jramsay42/Digital-Multimeter-v0.01/Multimeter.pdf

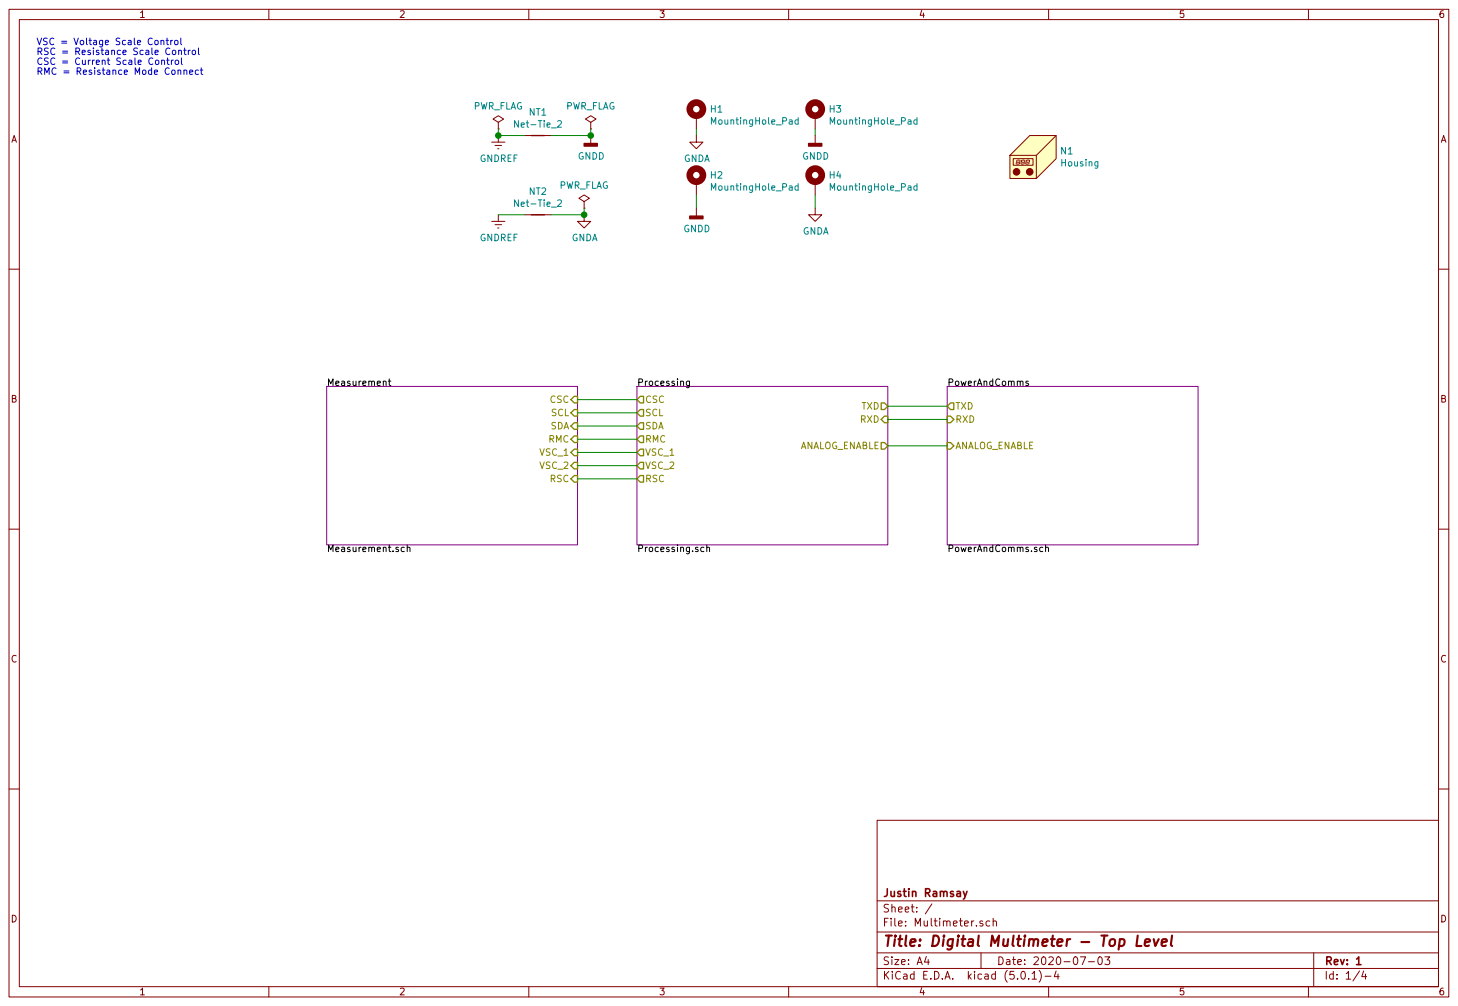
[picture p1: page 1]

PowerAndComms PowerAndComms.sch TXD

Id: 1/4 Title: Digital Multimeter - Top Level File: Multimeter.sch Sheet: / Justin Ramsay

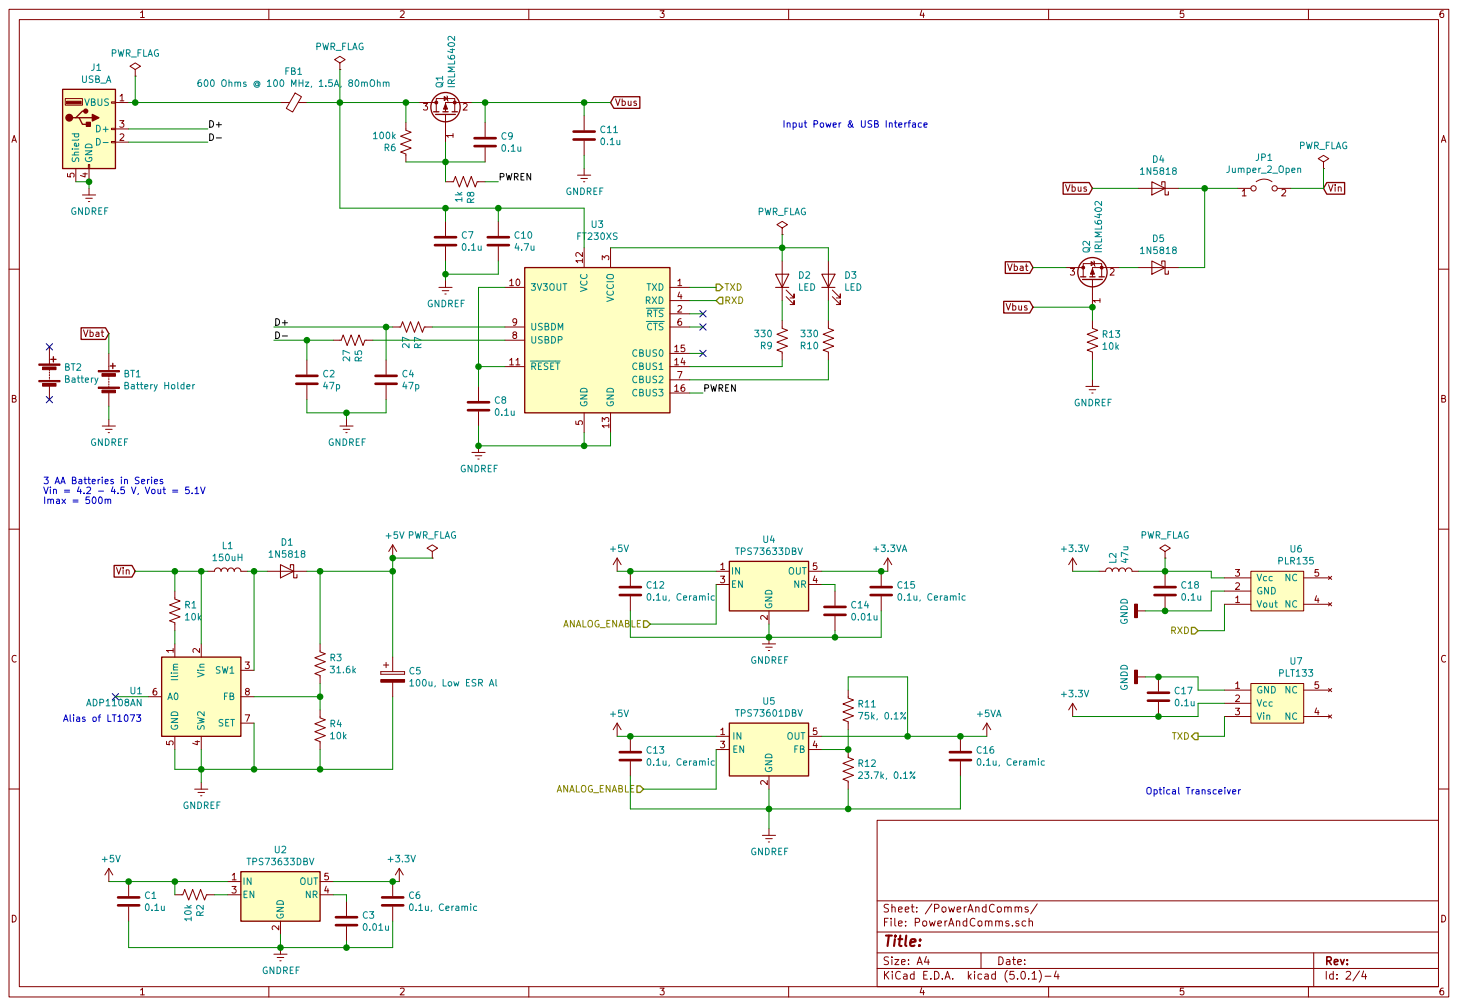
[picture p2: page 2]

3 AA Batteries in Series Vin = 4.2 - 4.5 V, Vout = 5.1V
Imax = 500m

Id: 2/4 Title: File: PowerAndComms.sch Sheet: /PowerAndComms/

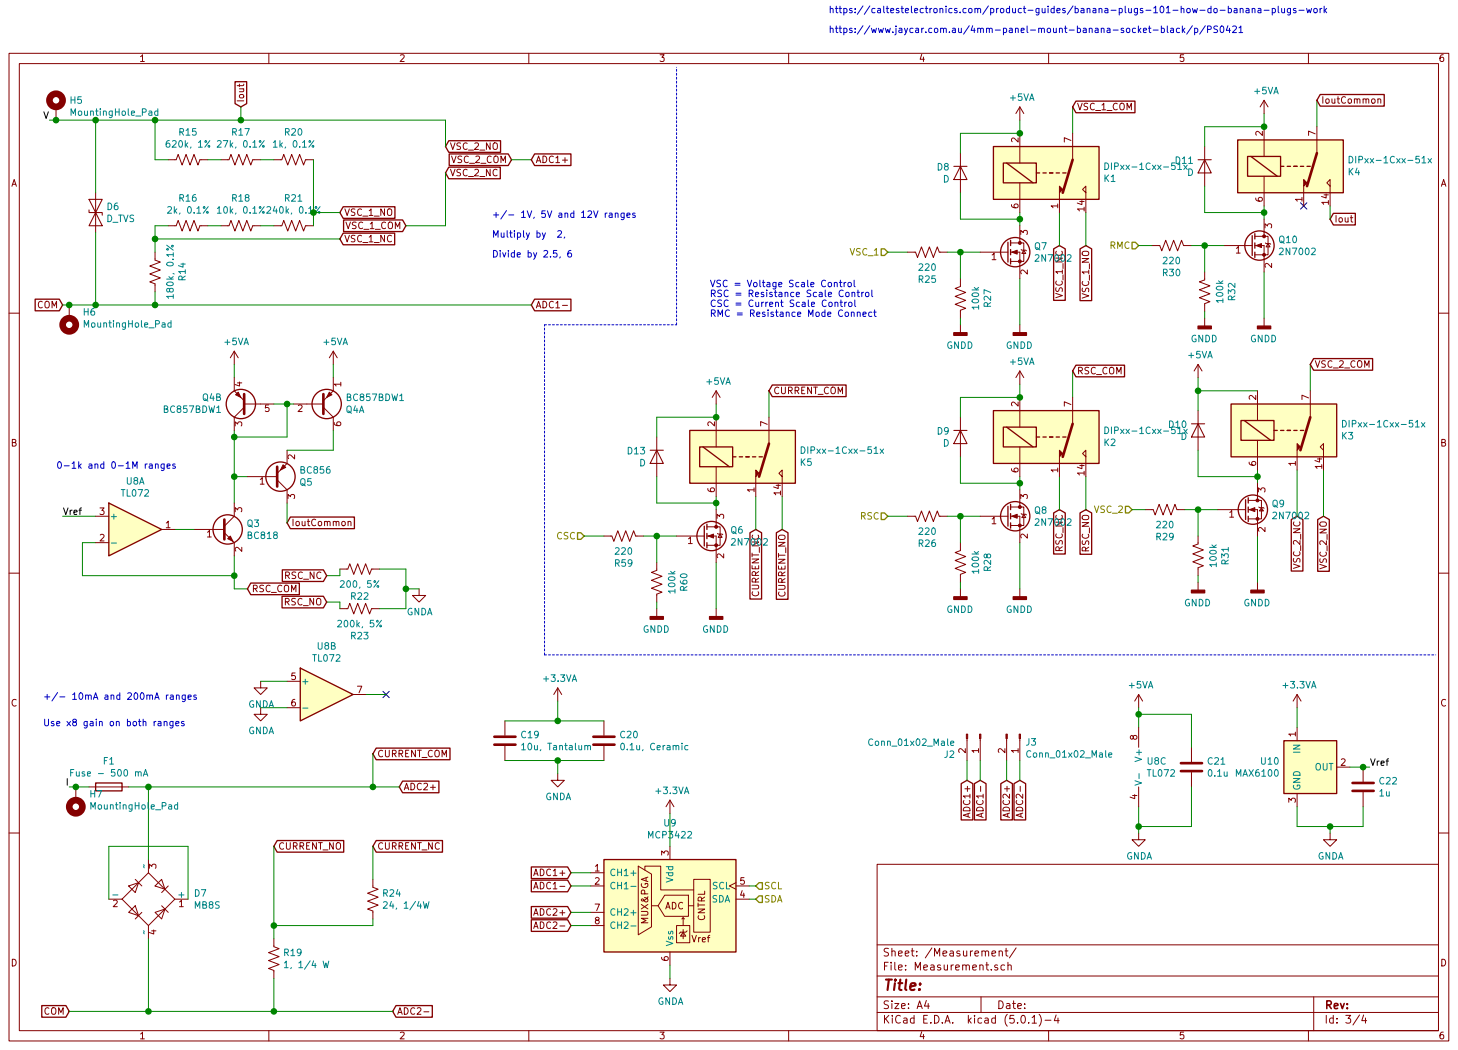
[picture p3: page 3]

https://caltestelectronics.com/product-guides/banana-plugs-101-how-do-banana-plugs-work
https://www.jaycar.com.au/4mm-panel-mount-banana-socket-black/p/PS0421

VSC = Voltage Scale Control RSC = Resistance Scale Control CSC = Current Scale Control RMC = Resistance Mode Connect SCL SDA GNDA

Id: 3/4 Title: File: Measurement.sch Sheet: /Measurement/

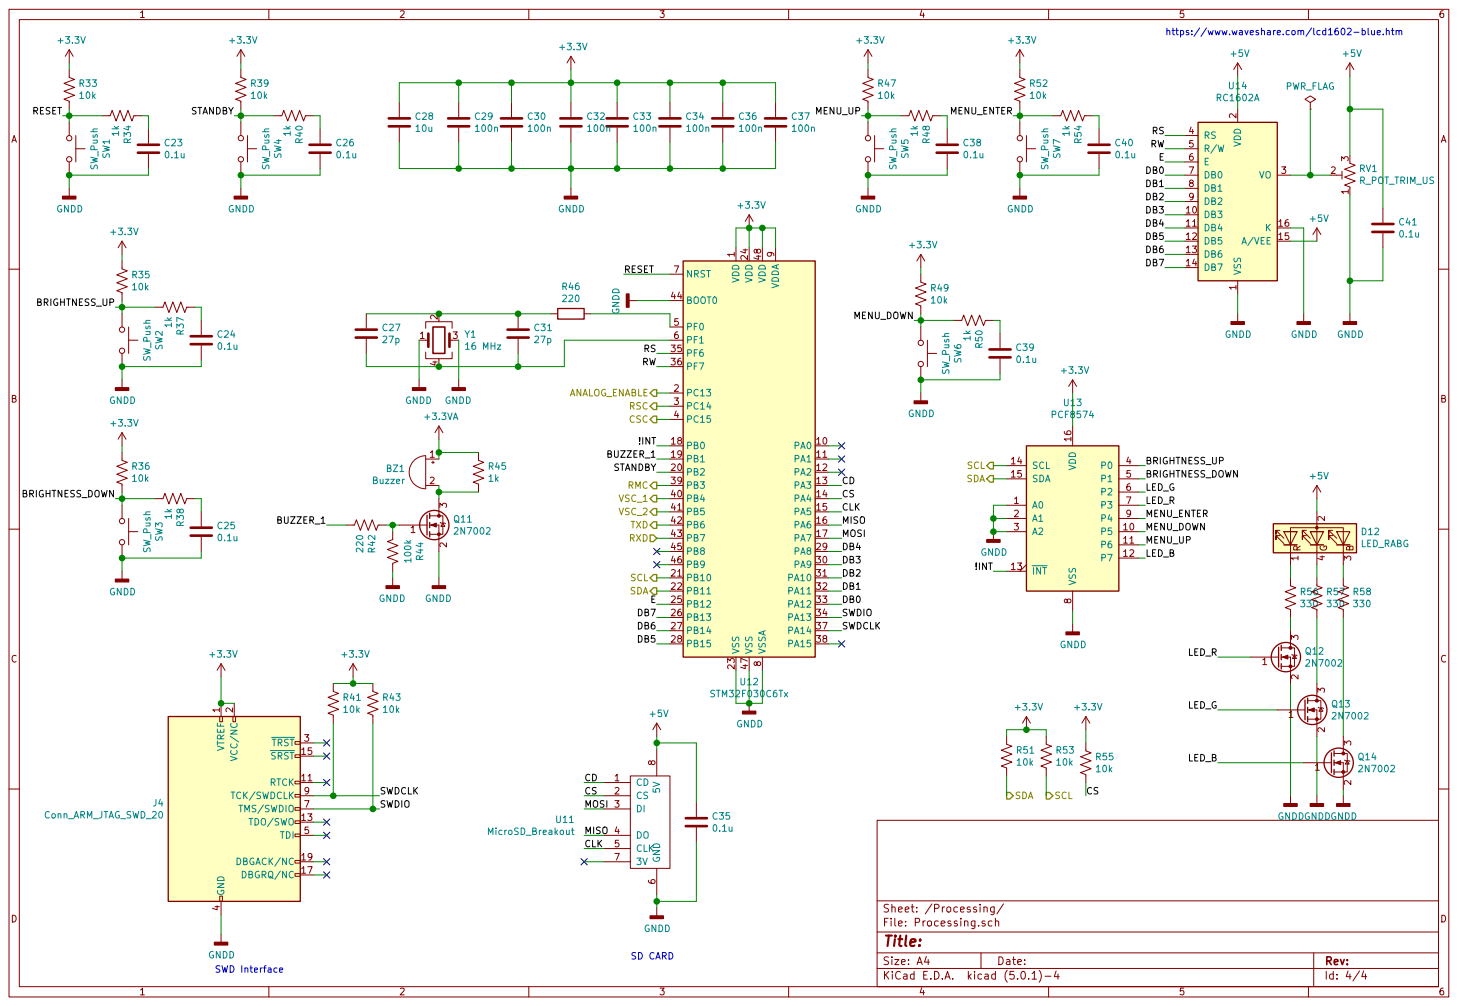
[picture p4: page 4]

https://www.waveshare.com/lcd1602-blue.htm VSS
+5V GNDD

1 RTCK 11 TDO/SWO 13 SRST 15 DBGRQ/NC 17 DBGACK/NC 19 VCC/NC
SWDIO VTREF

4 TDI 5 TMS/SWDIO 7 TCK/SWDCLK 9
