jramsay42/Digital-Multimeter-v0.01/Multimeter.kicad_pcb

## KiCad design Multimeter.kicad_pcb (2021-04-07)

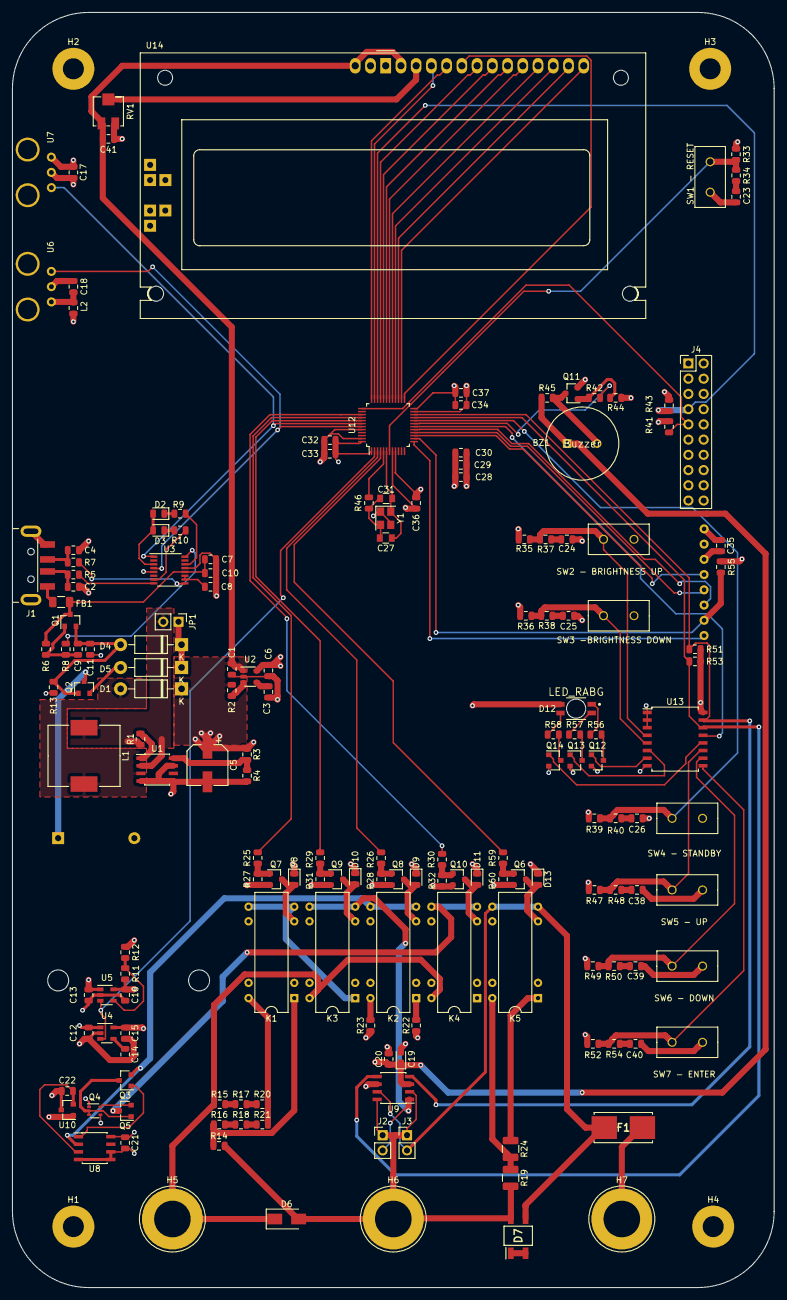
[picture p5: board Multimeter.kicad_pcb from above]

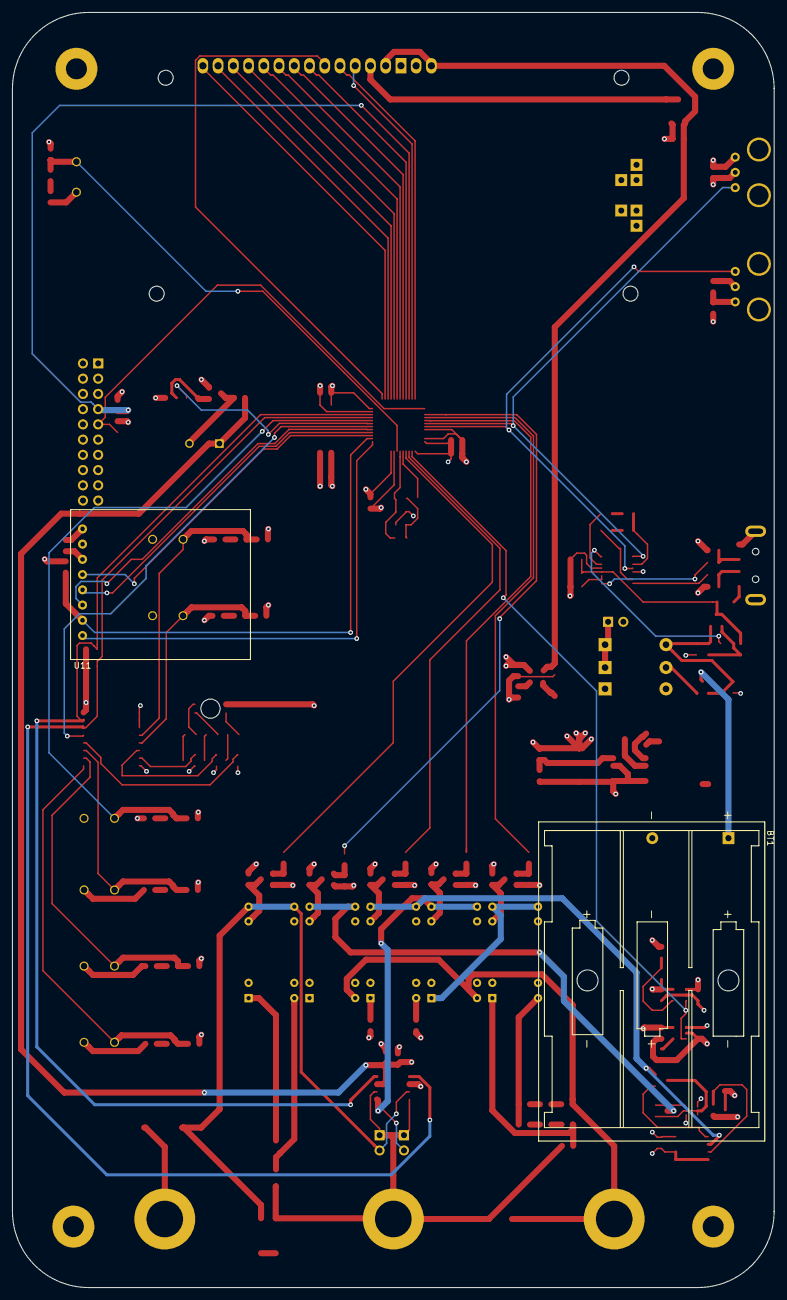
[picture p6: board Multimeter.kicad_pcb from below]

Board: 4 copper layers, 127.0 x 212.6 mm, 174 parts (2 on the bottom side), 126 nets.

Parts:
BT1: Battery Holder; Keystone_2479_3xAAA
BZ1: Buzzer; TDK-PS1240P02BT-0
C1, C7, C8, C9, C11, C17, C18, C21, C23, C24, C25, C26, C35, C38, C39, C40, C41: 0.1u; C_0805_2012Metric
C2, C4: 47p; C_0805_2012Metric
C3, C14: 0.01u; C_0805_2012Metric
C5: 100u, Low ESR Al; CP_Elec_6.3x5.4
C6, C12, C13, C15, C16, C20: 0.1u, Ceramic; C_0805_2012Metric
C10: 4.7u; C_0805_2012Metric
C19: 10u, Tantalum; CP_EIA-2012-12_Kemet-R_Pad1.30x1.05mm_HandSolder
C22: 1u; C_0805_2012Metric
C27, C31: 27p; C_0805
C28: 10u; C_0805_2012Metric
C29, C30, C32, C33, C34, C36, C37: 100n; C_0805_2012Metric
D1, D4, D5: 1N5818; D_DO-41_SOD81_P10.16mm_Horizontal
D2, D3: LED; D_0805_2012Metric
D6: D_TVS; D_SMA
D7: MB8S; SOP245P670X290-4N
D8, D9, D10, D11, D13: D; D_0805_2012Metric
D12: LED_RABG; SunLED-XZMDKCBDDG45S-9-MFG
F1: Fuse - 500 mA; 0154500DRT
FB1: 600 Ohms @ 100 MHz, 1.5A, 80mOhm; R_1206_3216Metric
H1, H2, H3, H4: MountingHole_Pad; MountingHole_3.5mm_Pad
H5, H6, H7: MountingHole_Pad; Banana_Jack_1Pin
J1: USB_A; USB_A_CNCTech_1001-011-01101_Horizontal
J2, J3: Conn_01x02_Male; PinHeader_1x02_P2.54mm_Vertical
J4: Conn_ARM_JTAG_SWD_20; PinHeader_2x10_P2.54mm_Vertical
JP1: Jumper_2_Open; PinHeader_1x02_P2.54mm_Vertical
K1, K2, K3, K4, K5: DIPxx-1Cxx-51x; Relay_StandexMeder_DIP_LowProfile
L1: 150uH; L_Wuerth_HCM-1240
L2: 47u; L_0805_2012Metric
Q1, Q2: IRLML6402; SOT-23
Q3: BC818; SOT-23
Q4: BC857BDW1; SOT-363_SC-70-6
Q5: BC856; SOT-23
Q6, Q7, Q8, Q9, Q10, Q11, Q12, Q13, Q14: 2N7002; SOT-23
R1, R2, R4, R13, R33, R35, R36, R39, R41, R43, R47, R49, R51, R52, R53, R55: 10k; R_0805_2012Metric
R3: 31.6k; R_0805_2012Metric
R5, R7: 27; R_0805_2012Metric
R6, R27, R28, R31, R32, R44, R60: 100k; R_0805_2012Metric
R8, R34, R37, R38, R40, R45, R48, R50, R54: 1k; R_0805_2012Metric
R9, R10, R56, R57, R58: 330; R_0805_2012Metric
R11: 75k, 0.1%; R_0805_2012Metric
R12: 23.7k, 0.1%; R_0805_2012Metric
R14: 180k, 0.1%; R_0805_2012Metric
R15: 620k, 1%; R_0805_2012Metric
R16: 2k, 0.1%; R_0805_2012Metric
R17: 27k, 0.1%; R_0805_2012Metric
R18: 10k, 0.1%; R_0805_2012Metric
R19: 1, 1/4 W; R_1210_3225Metric
R20: 1k, 0.1%; R_0805_2012Metric
R21: 240k, 0.1%; R_0805_2012Metric
R22: 200, 5%; R_0805_2012Metric
R23: 200k, 5%; R_0805_2012Metric
R24: 24, 1/4W; R_1210_3225Metric
R25, R26, R29, R30, R42, R46, R59: 220; R_0805_2012Metric
RV1: R_POT_TRIM_US; Potentiometer_Bourns_3214J_Horizontal
SW1 - RESET, SW2 - BRIGHTNESS UP, SW3 -BRIGHTNESS DOWN, SW4 - STANDBY, SW5 - UP, SW6 - DOWN, SW7 - ENTER: SW_Push; SPST-800SP9B6M2RE
U1: ADP1108AN; SOIC-8_3.9x4.9mm_P1.27mm
U2, U4: TPS73633DBV; SOT-23-5
U3: FT230XS; SSOP-16_3.9x4.9mm_P0.635mm
U5: TPS73601DBV; SOT-23-5
U6: PLR135; Everlight - PLR135
U7: PLT133; Everlight - PLR135
U8: TL072; SOIC-8_3.9x4.9mm_P1.27mm
U9: MCP3422; SOIC-8_3.9x4.9mm_P1.27mm
U10: MAX6100; SOT-23
U11: MicroSD_Breakout
U12: STM32F030C6Tx; LQFP-48_7x7mm_P0.5mm
U13: PCF8574; SOIC-16W_7.5x10.3mm_Pitch1.27mm
U14: RC1602A
Y1: 16 MHz; Crystal_SMD_3225-4Pin_3.2x2.5mm

Connections:
+3.3VA: BZ1.1, C15.1, C19.1, C20.1, R45.1, U4.5, U9.3, U10.1
+3V3: C6.1, C17.2, C28.1, C29.1, C30.1, C32.1, C33.1, C34.1, C36.1, C37.1, J4.1, J4.2, L2.1, R33.1, R35.1, R36.1, R39.1, R41.1, R43.1, R47.1, R49.1, R51.1, R52.1, R53.1, R55.1, U2.5, U7.2, U12.1, U12.9, U12.24, U12.48, U13.16
+5V: C1.1, C5.1, C12.1, C13.1, C35.1, C41.1, D1.1, D12.2, R2.2, R3.1, RV1.3, U2.1, U4.1, U5.1, U11.8, U14.2, U14.15
+5VA: C16.1, C21.1, D8.1, D9.1, D10.1, D11.1, D13.1, K1.2, K2.2, K3.2, K4.2, K5.2, Q4.1, Q4.4, R11.1, U5.5, U8.8
/Measurement/CSC: R59.1, U12.4
/Measurement/I: F1.2, H7.1
/Measurement/RMC: R30.1, U12.39
/Measurement/RSC: R26.1, U12.3
/Measurement/SCL: R53.2, U9.5, U12.21, U13.14
/Measurement/SDA: R51.2, U9.4, U12.22, U13.15
/Measurement/VSC_1: R25.1, U12.40
/Measurement/VSC_2: R29.1, U12.41
/Measurement/Vref: C22.1, U8.3, U10.2
/PowerAndComms/ANALOG_ENABLE: U4.3, U5.3, U12.2
/PowerAndComms/D+: C4.1, J1.3, R7.2
/PowerAndComms/D-: C2.1, J1.2, R5.2
/PowerAndComms/PWREN: R8.1, U3.16
/PowerAndComms/RXD: U3.4, U6.1, U12.43
/PowerAndComms/TXD: U3.1, U7.3, U12.42
/Processing/!INT: U12.18, U13.13
/Processing/BRIGHTNESS_DOWN: R36.2, R38.2, SW3 -BRIGHTNESS DOWN.1, U13.5
/Processing/BRIGHTNESS_UP: R35.2, R37.2, SW2 - BRIGHTNESS UP.1, U13.4
/Processing/BUZZER_1: R42.2, U12.19
/Processing/CD: U11.1, U12.13
/Processing/CLK: U11.5, U12.15
/Processing/CS: R55.2, U11.2, U12.14
/Processing/DB0: U12.33, U14.7
/Processing/DB1: U12.32, U14.8
/Processing/DB2: U12.31, U14.9
/Processing/DB3: U12.30, U14.10
/Processing/DB4: U12.29, U14.11
/Processing/DB5: U12.28, U14.12
/Processing/DB6: U12.27, U14.13
/Processing/DB7: U12.26, U14.14
/Processing/E: U12.25, U14.6
/Processing/LED_B: Q14.1, U13.12
/Processing/LED_G: Q13.1, U13.6
/Processing/LED_R: Q12.1, U13.7
/Processing/MENU_DOWN: R49.2, R50.2, SW6 - DOWN.1, U13.10
/Processing/MENU_ENTER: R52.2, R54.2, SW7 - ENTER.1, U13.9
/Processing/MENU_UP: R47.2, R48.2, SW5 - UP.1, U13.11
/Processing/MISO: U11.4, U12.16
/Processing/MOSI: U11.3, U12.17
/Processing/RESET: R33.2, R34.2, SW1 - RESET.1, U12.7
/Processing/RS: U12.35, U14.4
/Processing/RW: U12.36, U14.5
/Processing/STANDBY: R39.2, R40.2, SW4 - STANDBY.1, U12.20
/Processing/SWDCLK: J4.9, R41.2, U12.37
/Processing/SWDIO: J4.7, R43.2, U12.34
ADC1+: J2.2, K3.7, K3.8, U9.1
ADC1-: D6.2, D7.4, H6.1, J2.1, J3.1, R14.2, R19.2, U9.2, U9.8
ADC2+: D7.3, F1.1, J3.2, K5.7, K5.8, U9.7
CURRENT_NC: K5.1, R24.1
CURRENT_NO: K5.14, R19.1, R24.2
GNDA: C19.2, C20.2, C21.2, C22.2, H1.1, H4.1, R22.1, R23.1, U8.4, U8.5, U8.6, U9.6, U10.3
GNDD: C17.1, C18.2, C23.2, C24.2, C25.2, C26.2, C28.2, C29.2, C30.2, C32.2, C33.2, C34.2, C35.2, C36.2, C37.2, C38.2, C39.2, C40.2, C41.2, H2.1, H3.1, J4.4, J4.6, J4.8, J4.10, J4.12, J4.14, J4.16, J4.18, J4.20, Q6.2, Q7.2, Q8.2, Q9.2, Q10.2, Q11.2, Q12.2, Q13.2, Q14.2, R27.1, R28.1, R31.1, R32.1, R44.1, R60.1, RV1.1, SW1 - RESET.2, SW2 - BRIGHTNESS UP.2, SW3 -BRIGHTNESS DOWN.2, SW4 - STANDBY.2, SW5 - UP.2, SW6 - DOWN.2, SW7 - ENTER.2, U6.2, U7.1, U11.6, U12.8, U12.23, U12.44, U12.47, U13.1, U13.2, U13.3, U13.8, U14.1, U14.16, Y1.1, Y1.3
GNDREF: BT1.2, C1.2, C2.2, C3.2, C4.2, C5.2, C6.2, C7.2, C8.2, C10.2, C11.2, C12.2, C13.2, C14.2, C15.2, C16.2, J1.4, J1.5, R4.2, R12.2, R13.2, U1.4, U1.5, U1.7, U2.2, U3.5, U3.13, U4.2, U5.2
Iout: D6.1, H5.1, K3.14, K4.14, R15.1
IoutCommon: K4.7, K4.8, Q5.3
unnamed: BZ1.2, Q11.3, R45.2
unnamed: C3.1, U2.4
unnamed: C8.1, U3.10, U3.11
unnamed: C9.2, Q1.1, R6.1, R8.2
unnamed: C7.1, C10.1, FB1.1, Q1.3, R6.2, U3.12
unnamed: C14.1, U4.4
unnamed: C18.1, L2.2, U6.3
unnamed: C23.1, R34.1
unnamed: C24.1, R37.1
unnamed: C25.1, R38.1
unnamed: C26.1, R40.1
unnamed: C27.1, C31.1, R46.2, Y1.2
unnamed: C27.2, C31.2, U12.6, Y1.4
unnamed: C38.1, R48.1
unnamed: C39.1, R50.1
unnamed: C40.1, R54.1
unnamed: D1.2, L1.2, U1.3
unnamed: D2.1, R9.2
unnamed: D2.2, D3.2, U3.3
unnamed: D3.1, R10.2
unnamed: D4.1, D5.1, JP1.1
unnamed: D5.2, Q2.2
unnamed: D7.1, D7.2
unnamed: D8.2, K1.6, Q7.3
unnamed: D9.2, K2.6, Q8.3
unnamed: D10.2, K3.6, Q9.3
unnamed: D11.2, K4.6, Q10.3
unnamed: D12.1, R56.1
unnamed: D12.3, R58.1
unnamed: D12.4, R57.1
unnamed: D13.2, K5.6, Q6.3
unnamed: FB1.2, J1.1
unnamed: Q3.1, U8.1
unnamed: Q3.3, Q4.2, Q4.3, Q4.5, Q5.1
unnamed: Q4.6, Q5.2
unnamed: Q6.1, R59.2, R60.2
unnamed: Q7.1, R25.2, R27.2
unnamed: Q8.1, R26.2, R28.2
unnamed: Q9.1, R29.2, R31.2
unnamed: Q10.1, R30.2, R32.2
unnamed: Q11.1, R42.1, R44.2
unnamed: Q12.3, R56.2
unnamed: Q13.3, R57.2
unnamed: Q14.3, R58.2
unnamed: R1.2, U1.1
unnamed: R2.1, U2.3
unnamed: R3.2, R4.1, U1.8
unnamed: R5.1, U3.8
unnamed: R7.1, U3.9
unnamed: R9.1, U3.14
unnamed: R10.1, U3.7
unnamed: R11.2, R12.1, U5.4
unnamed: R15.2, R17.1
unnamed: R16.2, R18.1
unnamed: R17.2, R20.1
unnamed: R18.2, R21.1
unnamed: R46.1, U12.5
unnamed: RV1.2, U14.3
RSC_COM: K2.7, K2.8, Q3.2, U8.2
RSC_NC: K2.1, R22.2
RSC_NO: K2.14, R23.2
VSC_1_COM: K1.7, K1.8, K3.1
VSC_1_NC: K1.1, R14.1, R16.1
VSC_1_NO: K1.14, R20.2, R21.2
Vbat: BT1.1, Q2.3
Vbus: C9.1, C11.1, D4.2, Q1.2, Q2.1, R13.1
Vin: JP1.2, L1.1, R1.1, U1.2
